Verboom30/CDFDR-2025/02_HW/Board_Main/Board_Main.step

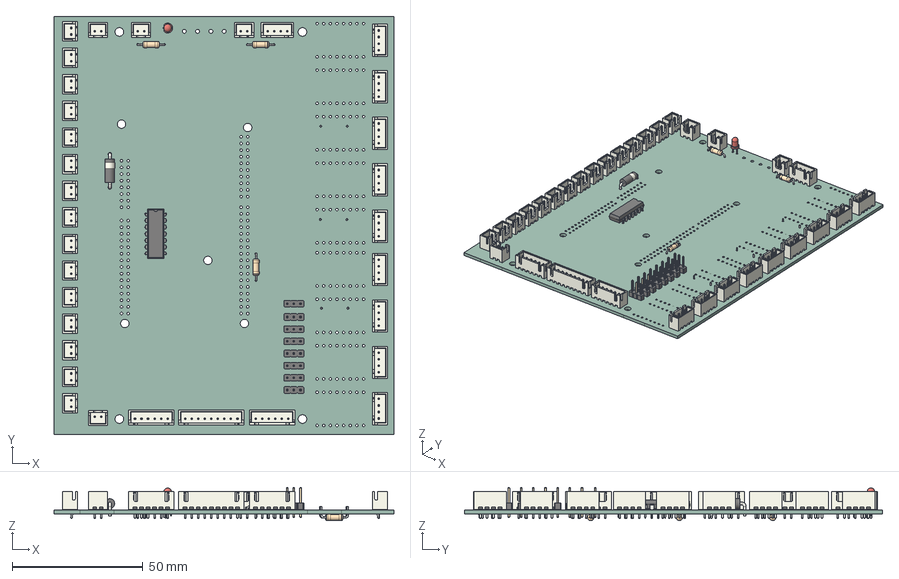
[picture p1: CAD file, 2025-04-05]
02_HW/Board_Main/Board_Main.step
130.0 x 160.0 x 12.7 mm
JST_XH_B2B-XH-A_1x02_P2.50mm_Vertical x 19
PinHeader_1x03_P2.54mm_Vertical x 8
LED_D3.0mm
JST_XH_B6B-XH-A_1x06_P2.50mm_Vertical x 2
JST_XH_B4B-XH-A_1x04_P2.50mm_Vertical x 10
R_Axial_DIN0207_L6.3mm_D2.5mm_P10.16mm_Horizontal x 6
D_5W_P12.70mm_Horizontal
DIP-14_W7.62mm
JST_XH_B9B-XH-A_1x09_P2.50mm_Vertical
Board_Main_PCB
