Verboom30/CDFDR-2025/02_HW/Board_PAMI/Board_PAMI/Board_PAMI.step

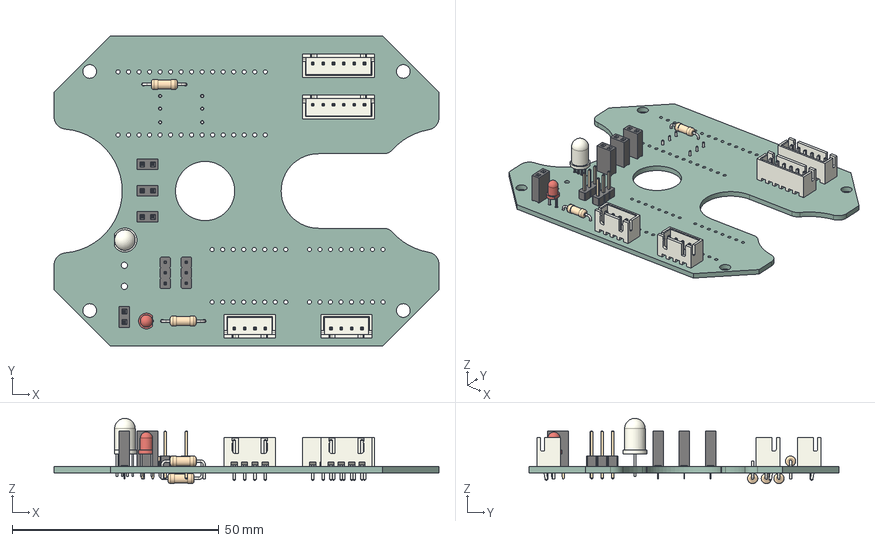
[picture p2: CAD file, 2025-04-05]
02_HW/Board_PAMI/Board_PAMI/Board_PAMI.step
93.0 x 75.0 x 15.8 mm
JST_XH_B6B-XH-A_1x06_P2.50mm_Vertical x 2
PinSocket_1x02_P2.54mm_Vertical x 4
LED_D5.0mm-4_RGB
JST_XH_B4B-XH-A_1x04_P2.50mm_Vertical x 2
R_Axial_DIN0207_L6.3mm_D2.5mm_P10.16mm_Horizontal x 5
LED_D3.0mm
PinHeader_1x03_P2.54mm_Vertical x 2
Board_PAMI_PCB
