Verboom30/CDFDR-2025/02_HW/Board_PAMI/CUT_PAMI.dxf

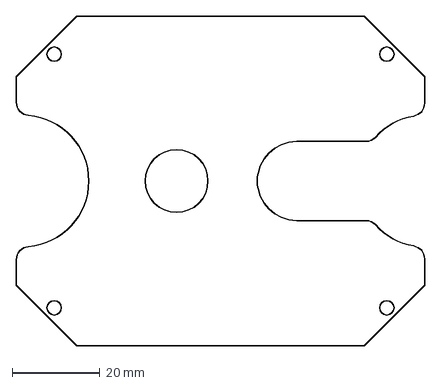
[picture p3: CAD file, 2025-04-05]
02_HW/Board_PAMI/CUT_PAMI.dxf
93.0 x 75.0 mm
