Verboom30/CDFDR-2025/02_HW/Board_PAMI/Board_PAMI/Board_PAMI.kicad_pcb

## KiCad design 02_HW/Board_PAMI/Board_PAMI/Board_PAMI.kicad_pcb (2025-04-05)

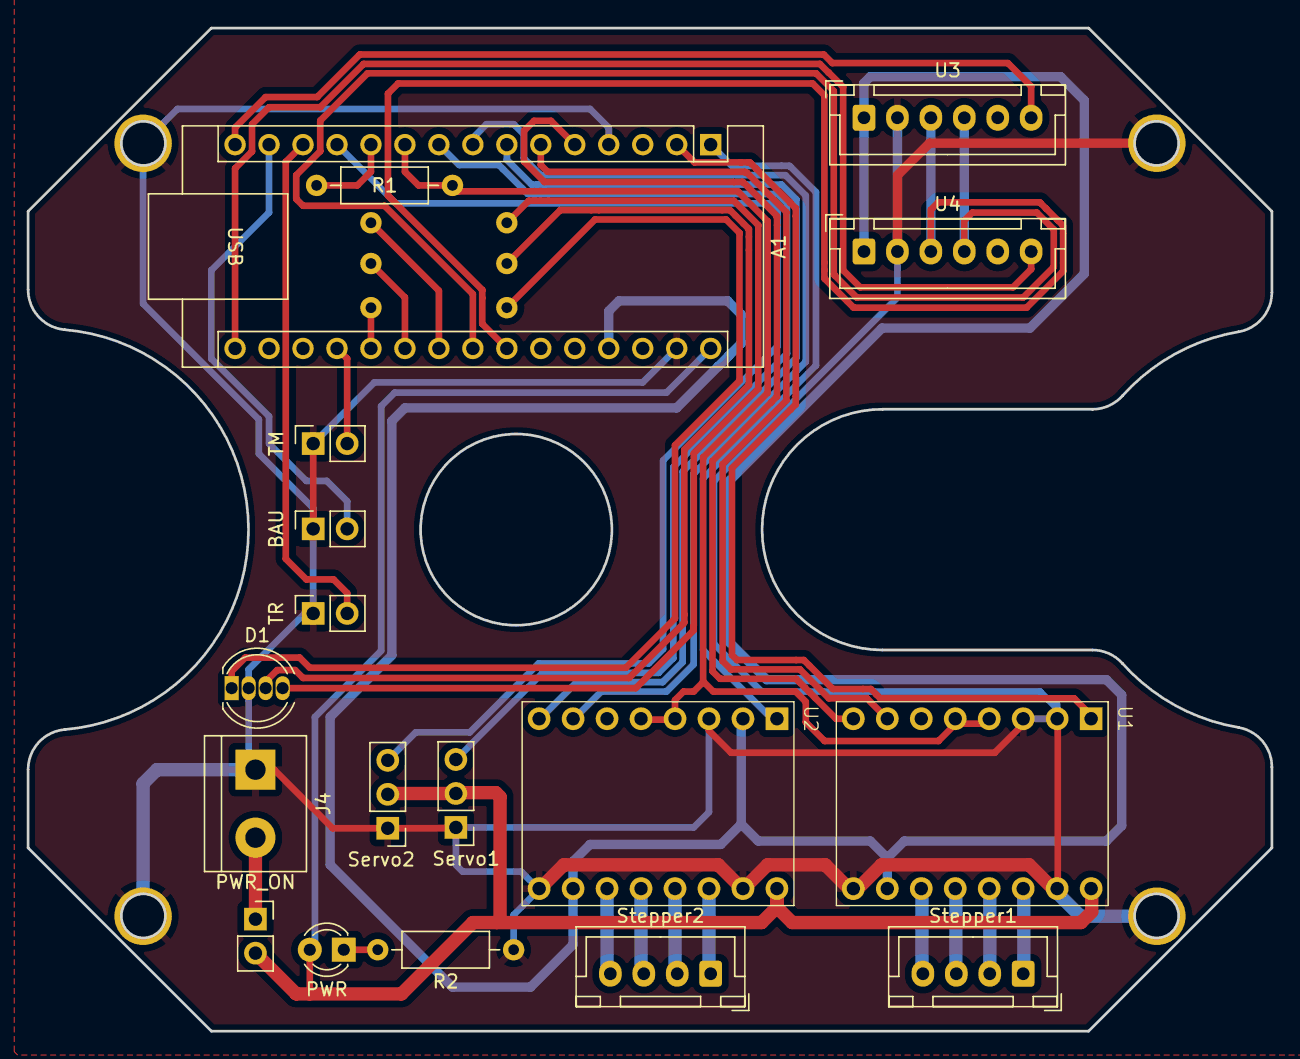
[picture p4: board Board_PAMI.kicad_pcb from above]

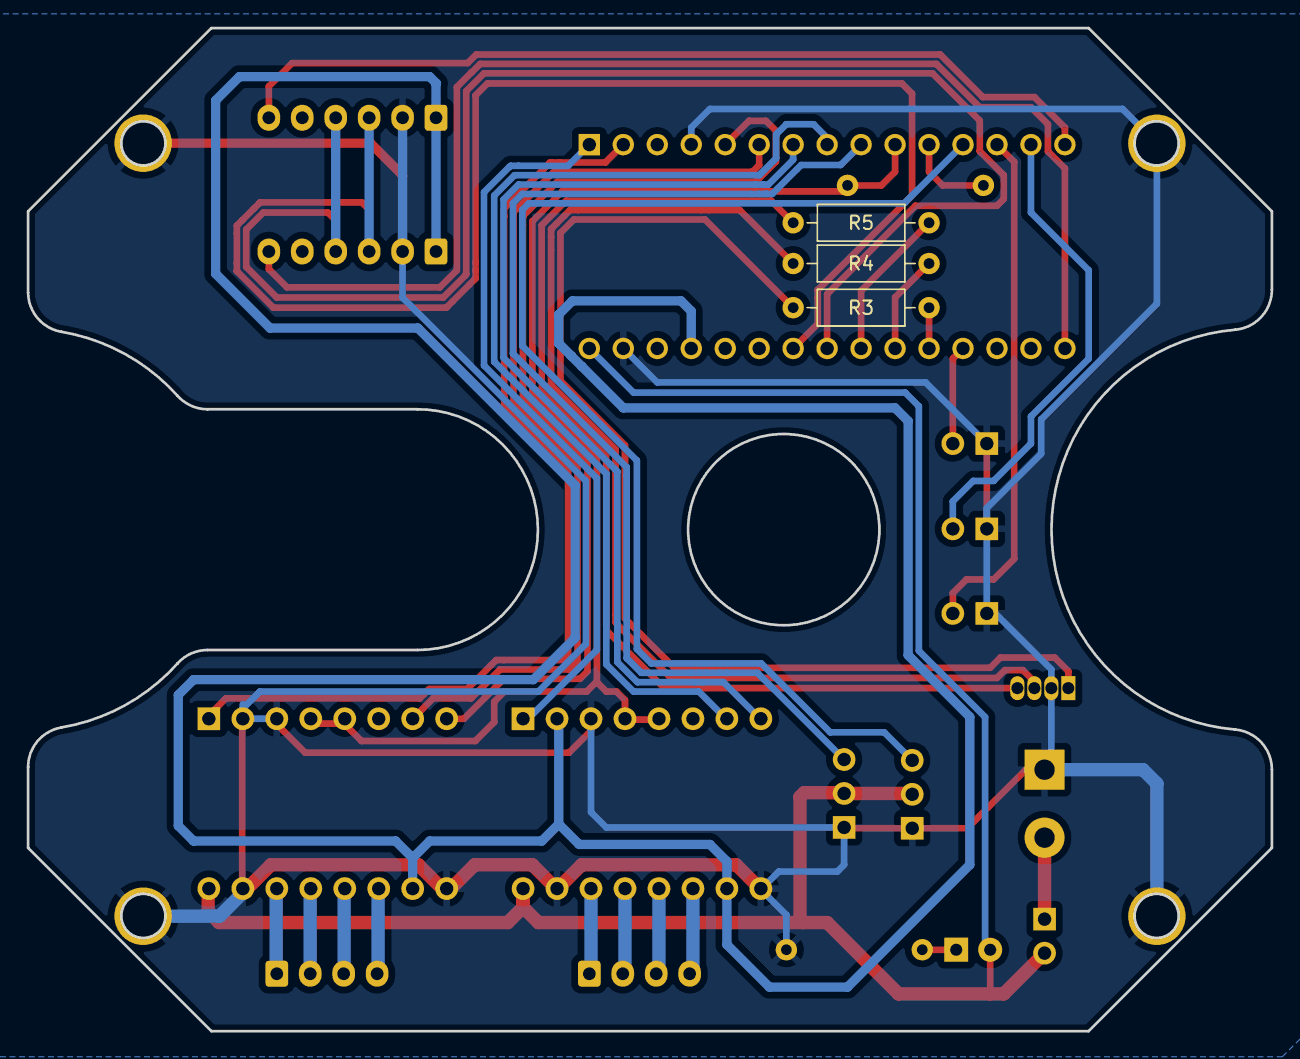
[picture p5: board Board_PAMI.kicad_pcb from below]

Board: 2 copper layers, 93.0 x 75.0 mm, 25 parts (3 on the bottom side), 36 nets.

Parts:
A1: Arduino_Nano_v3.x; Arduino_Nano
BAU: SW_BAU; PinSocket_1x02_P2.54mm_Vertical
D1: LED_BGKR; LED_D5.0mm-4_RGB_HOME
H1, H2, H3, H4: MountingHole_Pad; MountingHole_3.2mm_M3_DIN965_Pad_home
J4: ALIM; TerminalBlock_bornier-2_P5.08mm
PWR: LED_PWR; LED_D3.0mm
PWR_ON: PW_ON; PinSocket_1x02_P2.54mm_Vertical
R1: 1K; R_Axial_DIN0207_L6.3mm_D2.5mm_P10.16mm_Horizontal
R2, R3, R4, R5: 220R; R_Axial_DIN0207_L6.3mm_D2.5mm_P10.16mm_Horizontal
Servo1: SERVO_1; PinHeader_1x03_P2.54mm_Vertical
Servo2: SERVO_2; PinHeader_1x03_P2.54mm_Vertical
Stepper1: STEPPER_1; JST_XH_B4B-XH-A_1x04_P2.50mm_Vertical
Stepper2: STEPPER_2; JST_XH_B4B-XH-A_1x04_P2.50mm_Vertical
TM: SW_TEAM; PinSocket_1x02_P2.54mm_Vertical
TR: SW_TIRETTE; PinSocket_1x02_P2.54mm_Vertical
U1, U2: TMC2209
U3, U4: VL53L0XV2; JST_XH_B6B-XH-A_1x06_P2.50mm_Vertical

Connections:
/6V: J4.2, PWR_ON.1 (A)
DIR_1: A1.5 (D2), U1.8 (DIR)
DIR_2: A1.7 (D4), U2.8 (DIR)
EN_STP_1: A1.2 (D0/RX), U1.1 (EN)
EN_STP_2: A1.1 (D1/TX), U2.1 (EN)
GND: A1.4 (GND), A1.29 (GND), BAU.1, D1.3 (K), H1.1, H2.1, H3.1, H4.1, J4.1, R2.1, Servo1.1, Servo2.1, TM.1 (A), TR.1 (A), U1.2 (MS1), U1.3 (MS2), U1.10 (GND), U1.16 (GND), U2.3 (MS2), U2.10 (GND), U2.16 (GND), U3.2 (GND), U4.2 (GND)
LED_B: A1.22 (A3), R5.2
LED_G: A1.21 (A2), R4.2
LED_R: A1.20 (A1), R3.2
unnamed: A1.11 (D8), R1.2
unnamed: D1.1 (BA), R5.1
unnamed: D1.2 (GA), R4.1
unnamed: D1.4 (RA), R3.1
unnamed: PWR.1 (K), R2.2
unnamed: Stepper1.1, U1.11 (A2)
unnamed: Stepper1.2, U1.12 (A1)
unnamed: Stepper1.3, U1.13 (B1)
unnamed: Stepper1.4, U1.14 (B2)
unnamed: Stepper2.1, U2.11 (A2)
unnamed: Stepper2.2, U2.12 (A1)
unnamed: Stepper2.3, U2.13 (B1)
unnamed: Stepper2.4, U2.14 (B2)
PWM_SERVO_1: A1.9 (D6), Servo1.3
PWM_SERVO_2: A1.12 (D9), Servo2.3
SCL: A1.24 (A5), U3.3 (SCL), U4.3 (SCL)
SDA: A1.23 (A4), U3.4 (SDA), U4.4 (SDA)
STEP_1: A1.6 (D3), U1.7 (STEP)
STEP_2: A1.8 (D5), U2.7 (STEP)
SW_BAU: A1.14 (D11), BAU.2
SW_TM: A1.19 (A0), TM.2 (B)
SW_TR: A1.13 (D10), TR.2 (B)
UART_RX: A1.10 (D7), R1.1, U1.4 (UART_RX), U1.5 (UART_TX), U2.4 (UART_RX), U2.5 (UART_TX)
VCC: A1.27 (+5V), U1.15 (VCC), U2.2 (MS1), U2.15 (VCC), U3.1 (VCC), U4.1 (VCC)
VM: A1.30 (VIN), PWR.2 (A), PWR_ON.2 (B), Servo1.2, Servo2.2, U1.9 (VM), U2.9 (VM)
XSHUT_1: A1.15 (D12), U3.6 (XSHUT)
XSHUT_2: A1.16 (D13), U4.6 (XSHUT)
