Verboom30/CDFDR-2025/02_HW/Board_Main/Board_Main.kicad_pcb

## KiCad design 02_HW/Board_Main/Board_Main.kicad_pcb (2025-04-05)

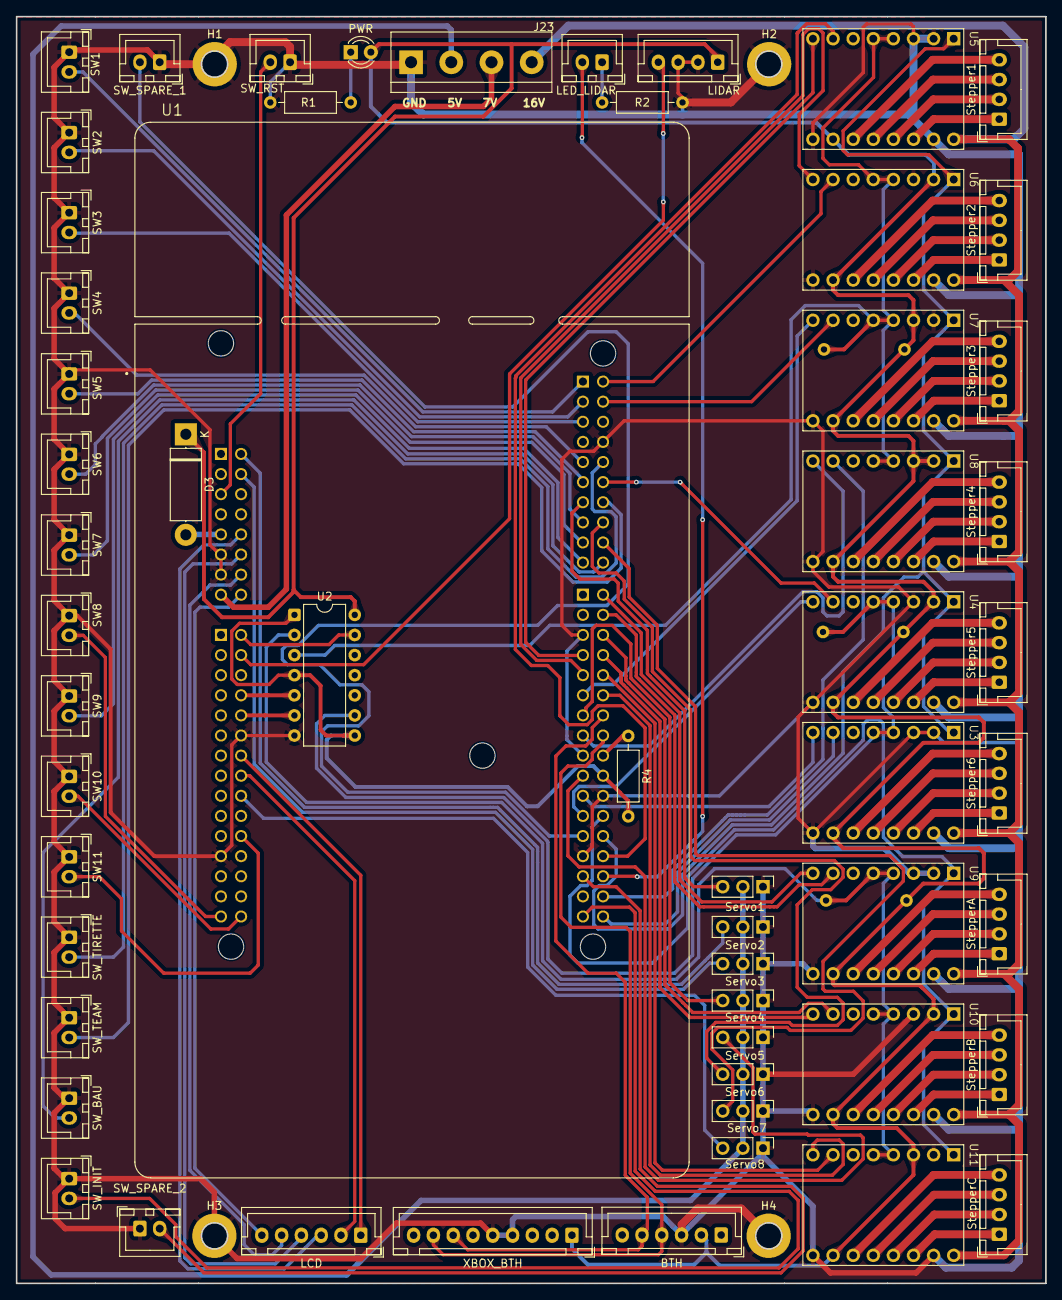
[picture p6: board Board_Main.kicad_pcb from above]

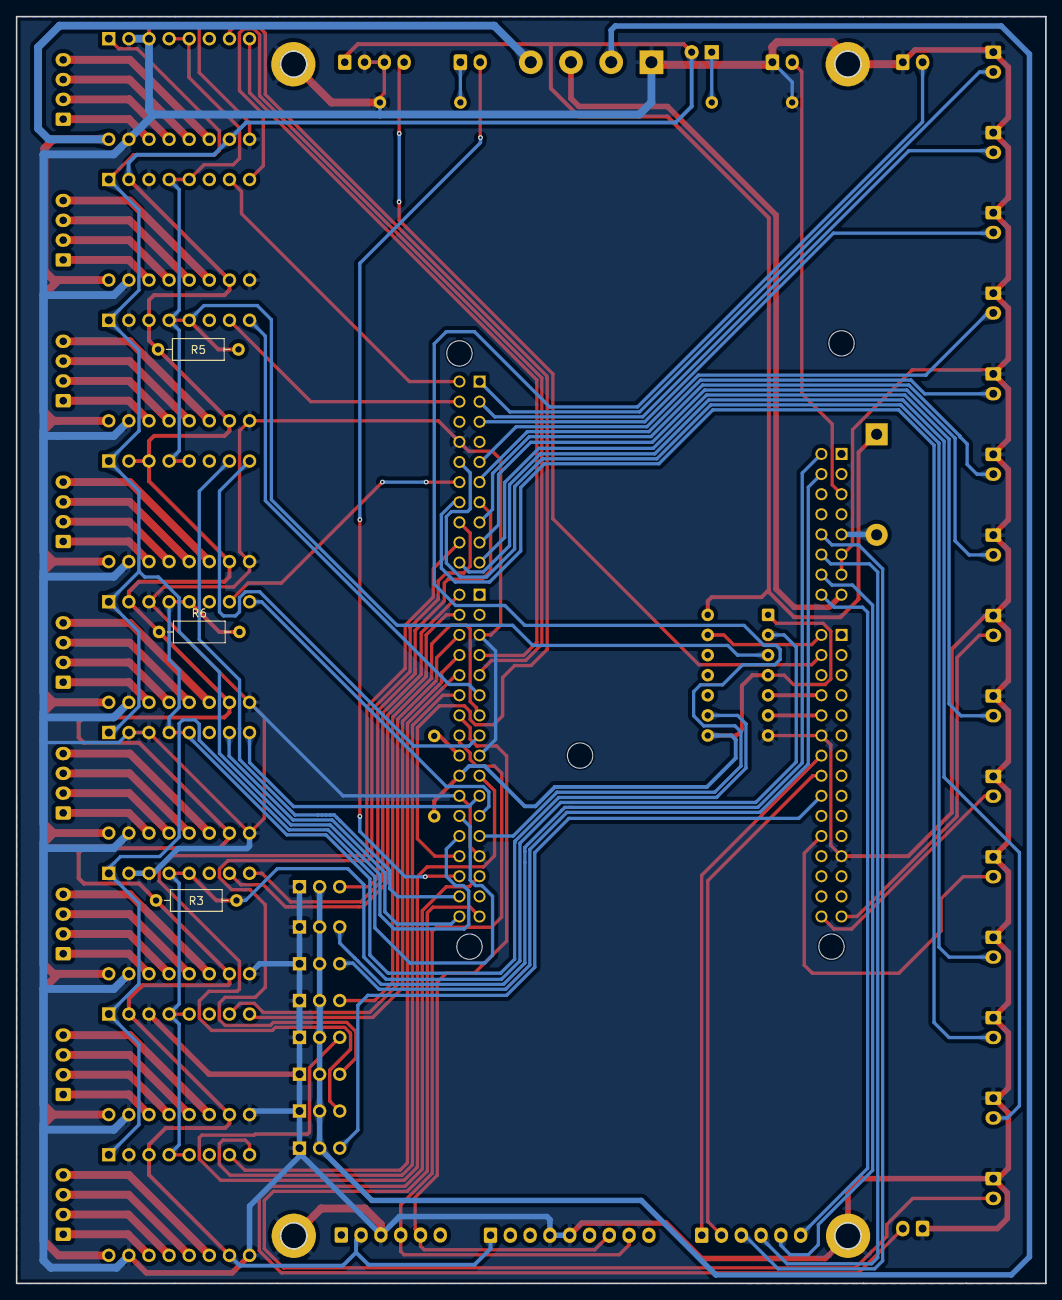
[picture p7: board Board_Main.kicad_pcb from below]

Board: 2 copper layers, 130.0 x 160.0 mm, 64 parts (3 on the bottom side), 108 nets.

Parts:
BTH: BTH; JST_XH_B6B-XH-A_1x06_P2.50mm_Vertical
D3: D; D_5W_P12.70mm_Horizontal
H1, H2, H3, H4: MountingHole_Pad; MountingHole_3.2mm_M3_DIN965_Pad
J23: ALIM; TerminalBlock_bornier-4_P5.08mm
LCD: LCD; JST_XH_B6B-XH-A_1x06_P2.50mm_Vertical
LED_LIDAR: LED_LIDAR; JST_XH_B2B-XH-A_1x02_P2.50mm_Vertical
LIDAR: LIDAR; JST_XH_B4B-XH-A_1x04_P2.50mm_Vertical
PWR: LED_PWR; LED_D3.0mm
R1, R2: 220R; R_Axial_DIN0207_L6.3mm_D2.5mm_P10.16mm_Horizontal
R3, R5, R6: 22K; R_Axial_DIN0207_L6.3mm_D2.5mm_P10.16mm_Horizontal
R4: 1K; R_Axial_DIN0207_L6.3mm_D2.5mm_P10.16mm_Horizontal
SW1, SW2, SW3, SW4, SW5, SW6, SW7, SW8, SW9, SW10, SW11: SW_Push; JST_XH_B2B-XH-A_1x02_P2.50mm_Vertical
SW_BAU: SW_BAU; JST_XH_B2B-XH-A_1x02_P2.50mm_Vertical
SW_INIT: SW_INIT; JST_XH_B2B-XH-A_1x02_P2.50mm_Vertical
SW_RST: SW_RST; JST_XH_B2B-XH-A_1x02_P2.50mm_Vertical
SW_SPARE_1: SW_SPARE_1; JST_XH_B2B-XH-A_1x02_P2.50mm_Vertical
SW_SPARE_2: SW_SPARE_2; JST_XH_B2B-XH-A_1x02_P2.50mm_Vertical
SW_TEAM: SW_TEAM; JST_XH_B2B-XH-A_1x02_P2.50mm_Vertical
SW_TIRETTE: SW_TIRETTE; JST_XH_B2B-XH-A_1x02_P2.50mm_Vertical
Servo1: Servo1; PinHeader_1x03_P2.54mm_Vertical
Servo2: Servo2; PinHeader_1x03_P2.54mm_Vertical
Servo3: Servo3; PinHeader_1x03_P2.54mm_Vertical
Servo4: Servo4; PinHeader_1x03_P2.54mm_Vertical
Servo5: Servo5; PinHeader_1x03_P2.54mm_Vertical
Servo6: Servo6; PinHeader_1x03_P2.54mm_Vertical
Servo7: Servo7; PinHeader_1x03_P2.54mm_Vertical
Servo8: Servo8; PinHeader_1x03_P2.54mm_Vertical
Stepper1: Stepper1; JST_XH_B4B-XH-A_1x04_P2.50mm_Vertical
Stepper2: Stepper2; JST_XH_B4B-XH-A_1x04_P2.50mm_Vertical
Stepper3: Stepper3; JST_XH_B4B-XH-A_1x04_P2.50mm_Vertical
Stepper4: Stepper4; JST_XH_B4B-XH-A_1x04_P2.50mm_Vertical
Stepper5: Stepper5; JST_XH_B4B-XH-A_1x04_P2.50mm_Vertical
Stepper6: Stepper6; JST_XH_B4B-XH-A_1x04_P2.50mm_Vertical
StepperA: StepperA; JST_XH_B4B-XH-A_1x04_P2.50mm_Vertical
StepperB: StepperB; JST_XH_B4B-XH-A_1x04_P2.50mm_Vertical
StepperC: StepperC; JST_XH_B4B-XH-A_1x04_P2.50mm_Vertical
U1: NUCLEO-F446ZE; MODULE_NUCLEO-F446ZE
U2: CD4066BE; DIP-14_W7.62mm
U3, U4, U5, U6, U7, U8, U9, U10, U11: TMC2209
XBOX_BTH: XBOX_BTH; JST_XH_B9B-XH-A_1x09_P2.50mm_Vertical

Connections:
BTH_RX: BTH.4, U1.CN10_16 (D0/USART_A_RX/PG_9), XBOX_BTH.8
BTH_TX: BTH.5, U1.CN10_14 (D1/USART_A_TX/PG_14), XBOX_BTH.7
DIR_1: U1.CN10_7 (PB_1), U5.8 (DIR)
DIR_2: U1.CN10_9 (PC_2), U6.8 (DIR)
DIR_3: U1.CN10_11 (PF_4), U7.8 (DIR)
DIR_4: U1.CN10_15 (PB_2), U8.8 (DIR)
DIR_5: U1.CN10_23 (PD_11), U4.8 (DIR)
DIR_6: U1.CN10_21 (PD_12), U3.8 (DIR)
DIR_A: U1.CN10_2 (D7/PF_13), U9.8 (DIR)
DIR_B: U1.CN10_8 (D4/PF_14), U10.8 (DIR)
DIR_C: U1.CN10_12 (D2/PF_15), U11.8 (DIR)
EN_DRIVE_N: U1.CN10_24 (PE_10), U9.1 (EN), U10.1 (EN), U11.1 (EN)
EN_STEP_N: U1.CN10_26 (PE_12), U3.1 (EN), U4.1 (EN), U5.1 (EN), U6.1 (EN), U7.1 (EN), U8.1 (EN)
GND: BTH.3, H1.1, H2.1, H3.1, H4.1, J23.1, LIDAR.2, LIDAR.3, R1.1, R2.1, SW1.1, SW2.1, SW3.1, SW4.1, SW5.1, SW6.1, SW7.1, SW8.1, SW9.1, SW10.1, SW11.1, SW_BAU.1, SW_INIT.1, SW_RST.1, SW_SPARE_1.1, SW_SPARE_2.1, SW_TEAM.1 (A), SW_TIRETTE.1 (A), Servo1.1, Servo2.1, Servo3.1, Servo4.1, Servo5.1, Servo6.1, Servo7.1, Servo8.1, U1.CN7_8 (GND), U1.CN8_11 (GND), U1.CN8_13 (GND), U1.CN9_12 (GND), U1.CN9_23 (GND), U1.CN10_5 (GND), U1.CN10_17 (GND), U1.CN10_22 (GND), U1.CN10_27 (GND), U2.7 (V_{SS}), U3.2 (MS1), U3.3 (MS2), U3.10 (GND), U3.16 (GND), U4.3 (MS2), U4.10 (GND), U4.16 (GND), U5.2 (MS1), U5.3 (MS2), U5.10 (GND), U5.16 (GND), U6.3 (MS2), U6.10 (GND), U6.16 (GND), U7.2 (MS1), U7.10 (GND), U7.16 (GND), U8.10 (GND), U8.16 (GND), U9.2 (MS1), U9.3 (MS2), U9.10 (GND), U9.16 (GND), U10.3 (MS2), U10.10 (GND), U10.16 (GND), U11.2 (MS1), U11.10 (GND), U11.16 (GND), XBOX_BTH.4, XBOX_BTH.5
LCD_D4: LCD.3, U1.CN8_10 (PC_12)
LCD_D5: LCD.4, U1.CN8_12 (PD_2)
LCD_D6: LCD.5, U1.CN8_14 (PG_2)
LCD_D7: LCD.6, U1.CN8_16 (PG_3)
LCD_EN: LCD.2, U1.CN9_16 (PE_4)
LCD_RS: LCD.1, U1.CN9_14 (PE_2)
LED_LIDAR: LED_LIDAR.2 (A), U1.CN10_30 (PE_15)
LIDAR_RX: LIDAR.4, U1.CN9_4 (PD_6)
unnamed: PWR.1 (K), R1.2
unnamed: LED_LIDAR.1 (K), R2.2
unnamed: D3.2 (A), U1.CN8_9 (+5V)
unnamed: Stepper1.1, U5.11 (A2)
unnamed: Stepper1.2, U5.12 (A1)
unnamed: Stepper1.3, U5.13 (B1)
unnamed: Stepper1.4, U5.14 (B2)
unnamed: Stepper2.1, U6.11 (A2)
unnamed: Stepper2.2, U6.12 (A1)
unnamed: Stepper2.3, U6.13 (B1)
unnamed: Stepper2.4, U6.14 (B2)
unnamed: Stepper3.1, U7.11 (A2)
unnamed: Stepper3.2, U7.12 (A1)
unnamed: Stepper3.3, U7.13 (B1)
unnamed: Stepper3.4, U7.14 (B2)
unnamed: Stepper4.1, U8.11 (A2)
unnamed: Stepper4.2, U8.12 (A1)
unnamed: Stepper4.3, U8.13 (B1)
unnamed: Stepper4.4, U8.14 (B2)
unnamed: Stepper5.1, U4.11 (A2)
unnamed: Stepper5.2, U4.12 (A1)
unnamed: Stepper5.3, U4.13 (B1)
unnamed: Stepper5.4, U4.14 (B2)
unnamed: Stepper6.1, U3.11 (A2)
unnamed: Stepper6.2, U3.12 (A1)
unnamed: Stepper6.3, U3.13 (B1)
unnamed: Stepper6.4, U3.14 (B2)
unnamed: StepperA.1, U9.11 (A2)
unnamed: StepperA.2, U9.12 (A1)
unnamed: StepperA.3, U9.13 (B1)
unnamed: StepperA.4, U9.14 (B2)
unnamed: StepperB.1, U10.11 (A2)
unnamed: StepperB.2, U10.12 (A1)
unnamed: StepperB.3, U10.13 (B1)
unnamed: StepperB.4, U10.14 (B2)
unnamed: StepperC.1, U11.11 (A2)
unnamed: StepperC.2, U11.12 (A1)
unnamed: StepperC.3, U11.13 (B1)
unnamed: StepperC.4, U11.14 (B2)
P5V: J23.2, Servo1.2, Servo2.2, Servo3.2, Servo4.2, Servo5.2, Servo6.2, Servo7.2, Servo8.2
P7V: J23.3, U1.CN8_15 (VIN)
PWM_SERVO_1: Servo1.3, U1.CN7_13 (PB_5)
PWM_SERVO_2: Servo2.3, U1.CN8_2 (PC_8)
PWM_SERVO_3: Servo3.3, U1.CN8_4 (PC_9)
PWM_SERVO_4: Servo4.3, U1.CN10_13 (PB_6)
PWM_SERVO_5: Servo5.3, U1.CN10_19 (PD_13)
PWM_SERVO_6: Servo6.3, U1.CN7_16 (D10/PD_14)
PWM_SERVO_7: Servo7.3, U1.CN7_18 (D9/PD_15)
PWM_SERVO_8: Servo8.3, U1.CN9_18 (PE_5)
SEL_UART_0: U1.CN9_2 (PD_7), U2.13
SEL_UART_1: U1.CN9_8 (PD_4), U2.5
SEL_UART_2: U1.CN9_10 (PD_3), U2.6
STEP_1: U1.CN10_28 (PE_14), U5.7 (STEP)
STEP_2: U1.CN7_2 (D15/PB_8), U6.7 (STEP)
STEP_3: U1.CN7_4 (D14/PB_9), U7.7 (STEP)
STEP_4: U1.CN10_32 (PB_10), U8.7 (STEP)
STEP_5: U1.CN7_12 (D12/PA_6), U4.7 (STEP)
STEP_6: U1.CN10_34 (PB_11), U3.7 (STEP)
STEP_A: U1.CN10_4 (D6/PE_9), U9.7 (STEP)
STEP_B: U1.CN10_6 (D5/PE_11), U10.7 (STEP)
STEP_C: U1.CN10_10 (D3/PE_13), U11.7 (STEP)
SW_1: SW1.2, U1.CN7_1 (PC_6)
SW_2: SW2.2, U1.CN7_3 (PB_15)
SW_3: SW3.2, U1.CN7_5 (PB_13)
SW_4: SW4.2, U1.CN7_9 (PA_15)
SW_5: SW5.2, U1.CN7_11 (PC_7)
SW_6: SW6.2, U1.CN7_15 (PB_3)
SW_7: SW7.2, U1.CN7_17 (PA_4)
SW_8: SW8.2, U1.CN9_29 (PG_0)
SW_9: SW9.2, U1.CN7_19 (PB_4)
SW_10: SW10.2, U1.CN9_30 (PG_1)
SW_11: SW11.2, U1.CN9_22 (PE_3)
SW_BAU: SW_BAU.2, U1.CN7_20 (D8/PF_12)
SW_INIT: SW_INIT.2, U1.CN10_33 (PE_0)
SW_RST: SW_RST.2, U1.CN8_5 (NRST)
SW_SPARE_1: SW_SPARE_1.2, U1.CN10_25 (PE_2)
SW_SPARE_2: SW_SPARE_2.2, U1.CN10_29 (PA_0)
SW_TM: SW_TEAM.2 (B), U1.CN7_14 (D11/PA_7)
SW_TR: SW_TIRETTE.2 (B), U1.CN7_10 (D13/FA_5)
UART_AD_0: R3.2, U2.2, U9.4 (UART_RX), U9.5 (UART_TX), U10.4 (UART_RX), U10.5 (UART_TX), U11.4 (UART_RX), U11.5 (UART_TX)
UART_AD_1: R5.2, U2.3, U5.4 (UART_RX), U5.5 (UART_TX), U6.4 (UART_RX), U6.5 (UART_TX), U7.4 (UART_RX), U7.5 (UART_TX), U8.4 (UART_RX), U8.5 (UART_TX)
UART_AD_2: R6.2, U2.9, U3.4 (UART_RX), U3.5 (UART_TX), U4.4 (UART_RX), U4.5 (UART_TX)
UART_RX: R4.2, U1.CN10_20 (PE_7), U2.1, U2.4, U2.8
UART_TX: R4.1, U1.CN10_18 (PE_8)
VBATT_16V: J23.4, U3.9 (VM), U4.9 (VM), U5.9 (VM), U6.9 (VM), U7.9 (VM), U8.9 (VM), U9.9 (VM), U10.9 (VM), U11.9 (VM)
VCC: BTH.2, D3.1 (K), LIDAR.1, PWR.2 (A), R3.1, R5.1, R6.1, U2.14 (V_{DD}), U3.15 (VCC), U4.2 (MS1), U4.15 (VCC), U5.15 (VCC), U6.2 (MS1), U6.15 (VCC), U7.3 (MS2), U7.15 (VCC), U8.2 (MS1), U8.3 (MS2), U8.15 (VCC), U9.15 (VCC), U10.2 (MS1), U10.15 (VCC), U11.3 (MS2), U11.15 (VCC), XBOX_BTH.1
