Verboom30/CDFDR-2025/(commit log)

2025-01-24 Mise sous forme de class
2025-01-24 Ajout des registres UART
2025-01-25 Ajout des registres de conf
2025-01-25 move stepper
2025-01-25 Ajout de la class holonome
2025-01-26 Ajout de la class SerialTMC
2025-01-26 Uart 3 steppers
2025-01-27 test 3 steppers OK
2025-03-15 PAMI test stepper OK
2025-04-05 test stepper TMC
2025-04-09 test servo
2025-04-11 Fix LCD, LCD on board not PCB
2025-04-12 Test StepperC
2025-04-14 test Stepper ok
2025-04-14 Revert "LinearActuator Init OK"
    This reverts commit d65db0a73475f8fb81b528ccc01d3694f585581c.
    [main.cpp]
2025-05-03 PAMI Stepper Gauche OK
2025-05-03 Stepper G et D OK
2025-05-08 Setup Actuator
2025-05-13 Deplacement relatif sur la table
2025-05-13 Deplacement absolu sur la table
2025-05-14 Correction erreur déplacement X Y
    [main.cpp]
2025-05-15 Correction dérive déplacement Soft
    [main.cpp]
2025-05-18 test 360 avec roue 15mm Done
2025-05-23 strategie 3 gradins Done + Temp de match et score
2025-05-25 Setup lidar
2025-05-25 Print Lidar
2025-05-25 Traitement trame Lidar Done
2025-05-26 Test Lidar Start and Stop
2025-05-27 Test Config Lidar OK
2025-05-27 Lidar Config aux petit oignons
2025-05-28 Kameleon Config Lidar
